jarkman/shonkbot/doc/img/phototranstisor.jpg

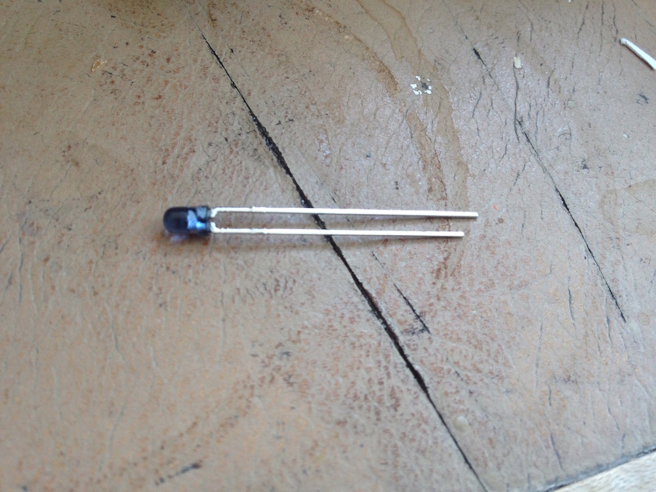
doc/img/phototranstisor.jpg
