jarkman/shonkbot/doc/img/tape1.jpg

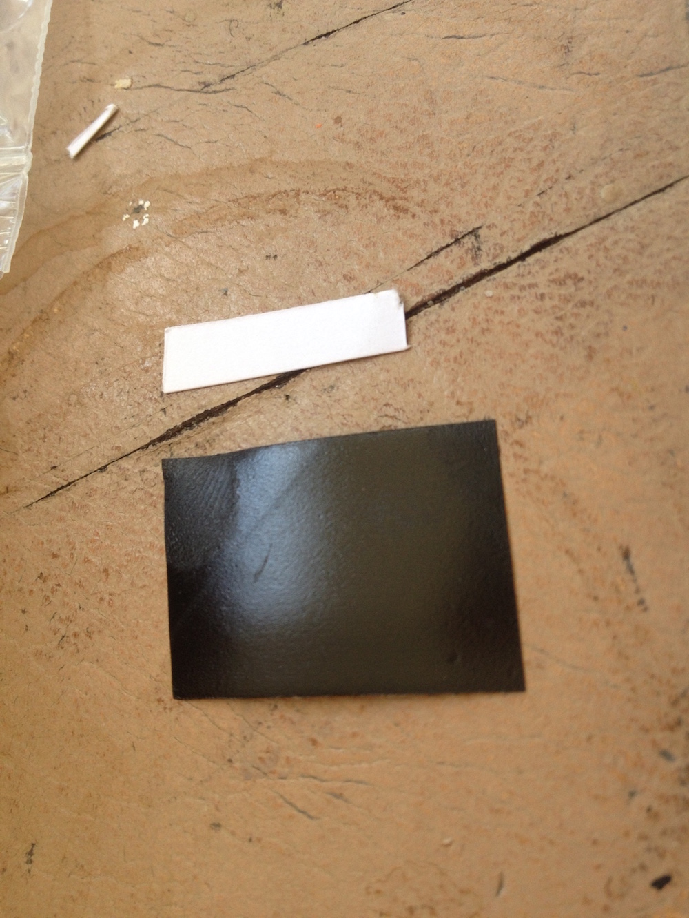
doc/img/tape1.jpg
