jarkman/shonkbot/doc/fritzing/connect_battery.png

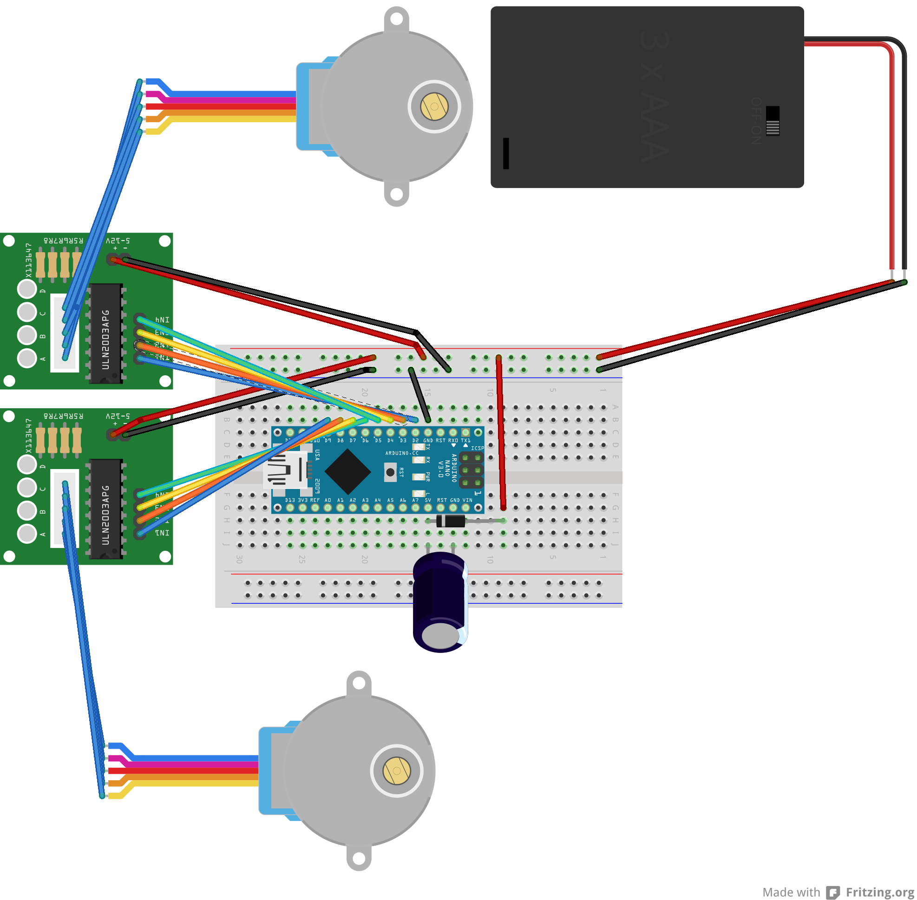
doc/fritzing/connect_battery.png
