jarkman/shonkbot/doc/fritzing/connect_motors2.png

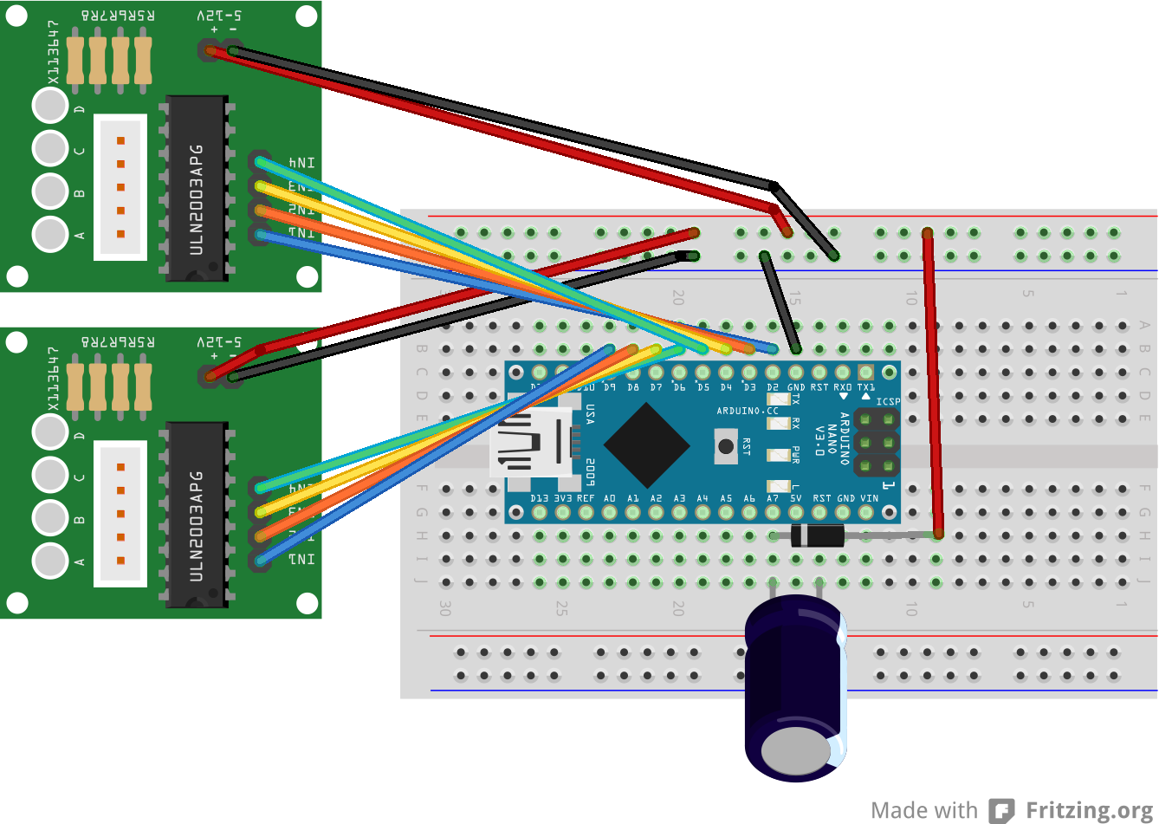
doc/fritzing/connect_motors2.png
