jarkman/shonkbot/doc/fritzing/connect_motors.png

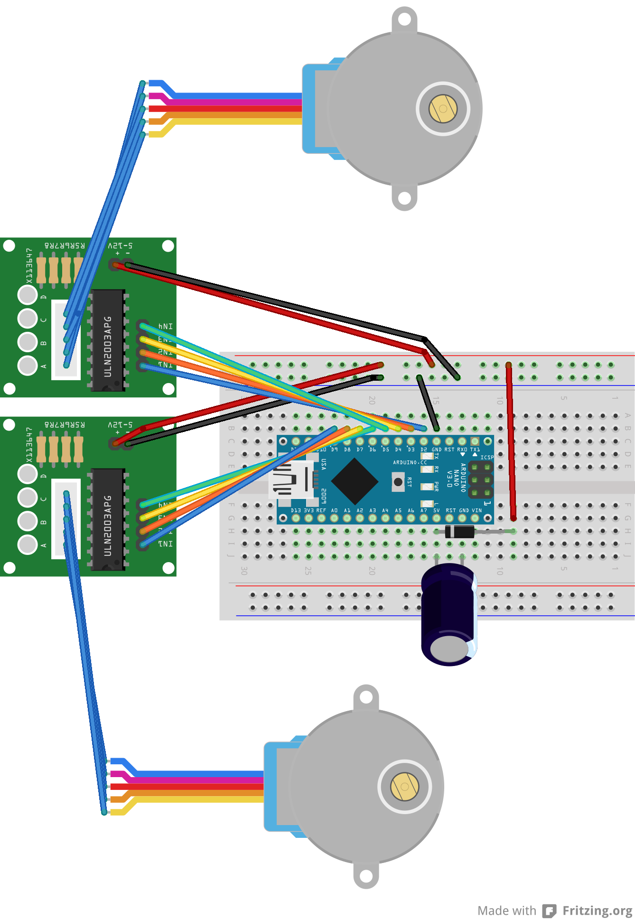
doc/fritzing/connect_motors.png
