jarkman/shonkbot/doc/fritzing/connect_power_supply.png

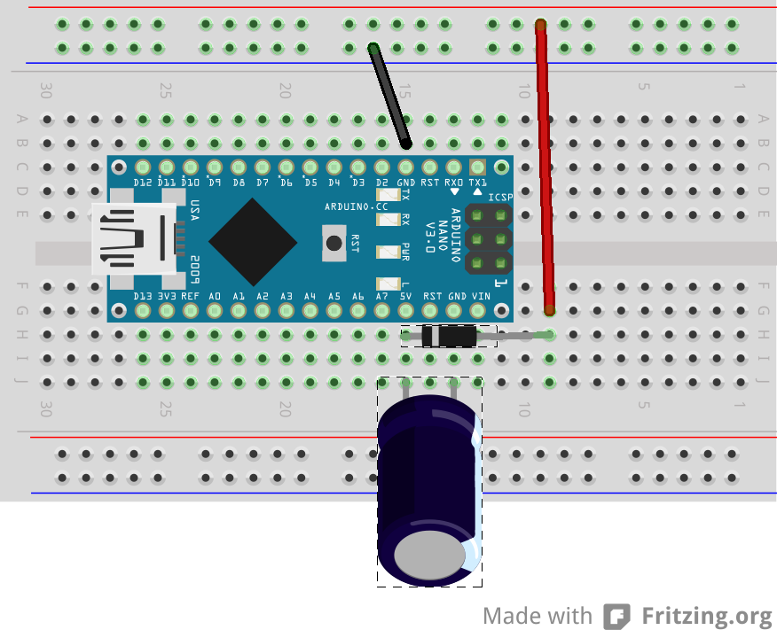
doc/fritzing/connect_power_supply.png
