jarkman/shonkbot/doc/fritzing/ir.png

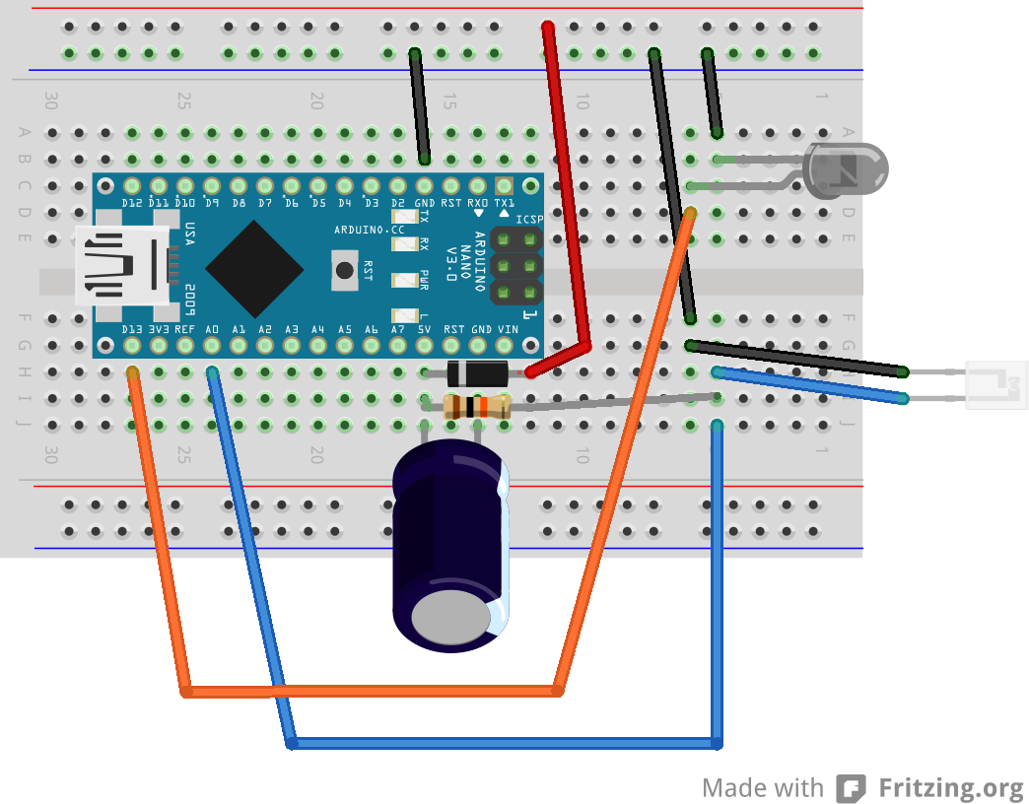
doc/fritzing/ir.png
