jarkman/shonkbot/doc/fritzing/just_led.png

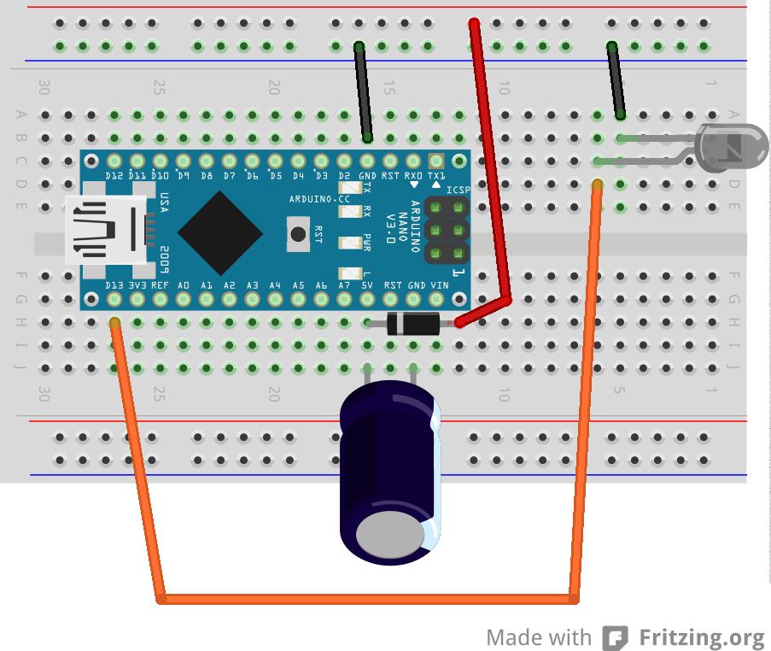
doc/fritzing/just_led.png
