jarkman/shonkbot/doc/fritzing/shonkbot.png

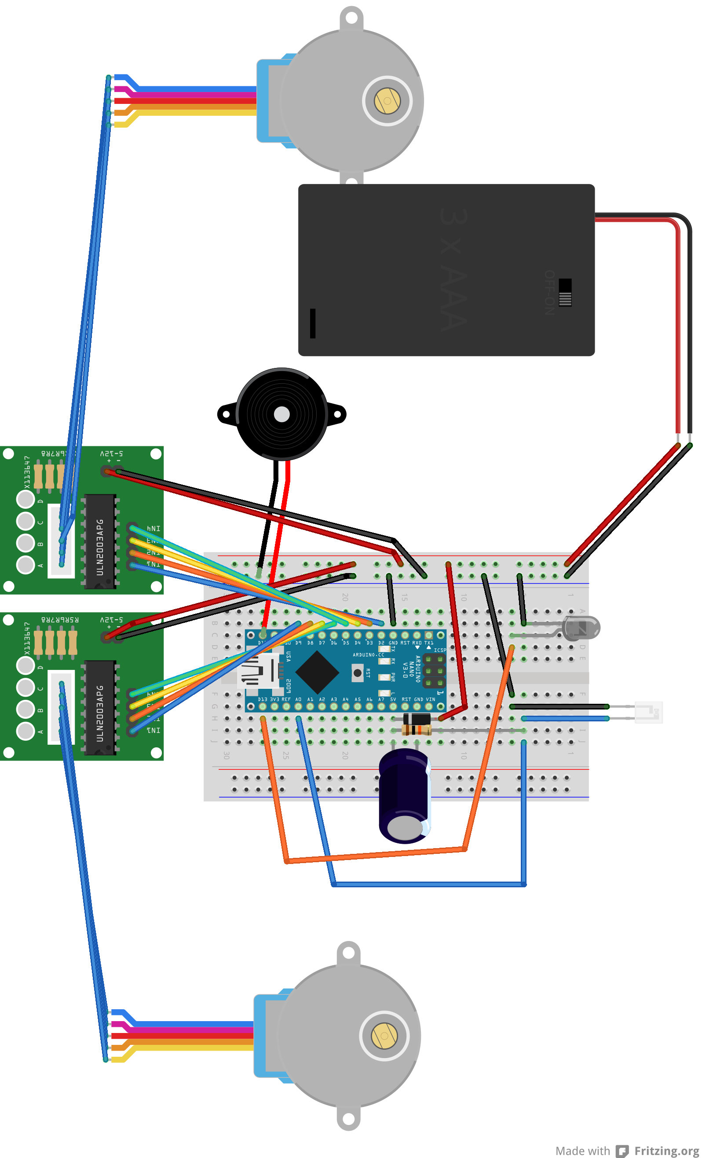
doc/fritzing/shonkbot.png
