jarkman/shonkbot/doc/img/big_led.png

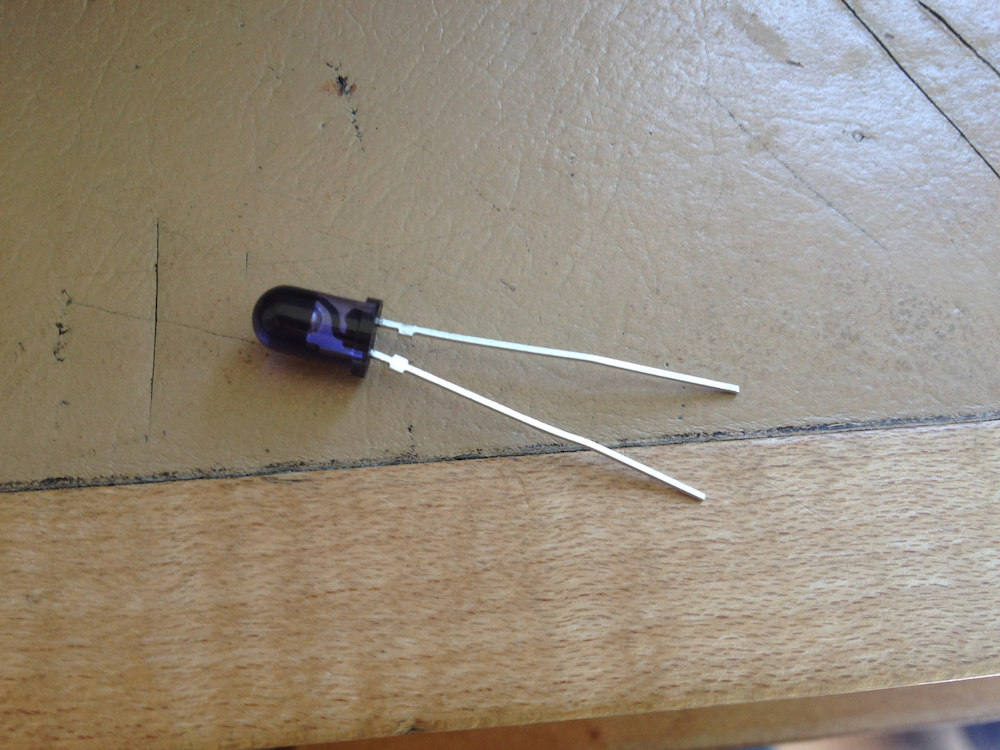
doc/img/big_led.png
