jarkman/shonkbot/doc/img/ir_led.jpg

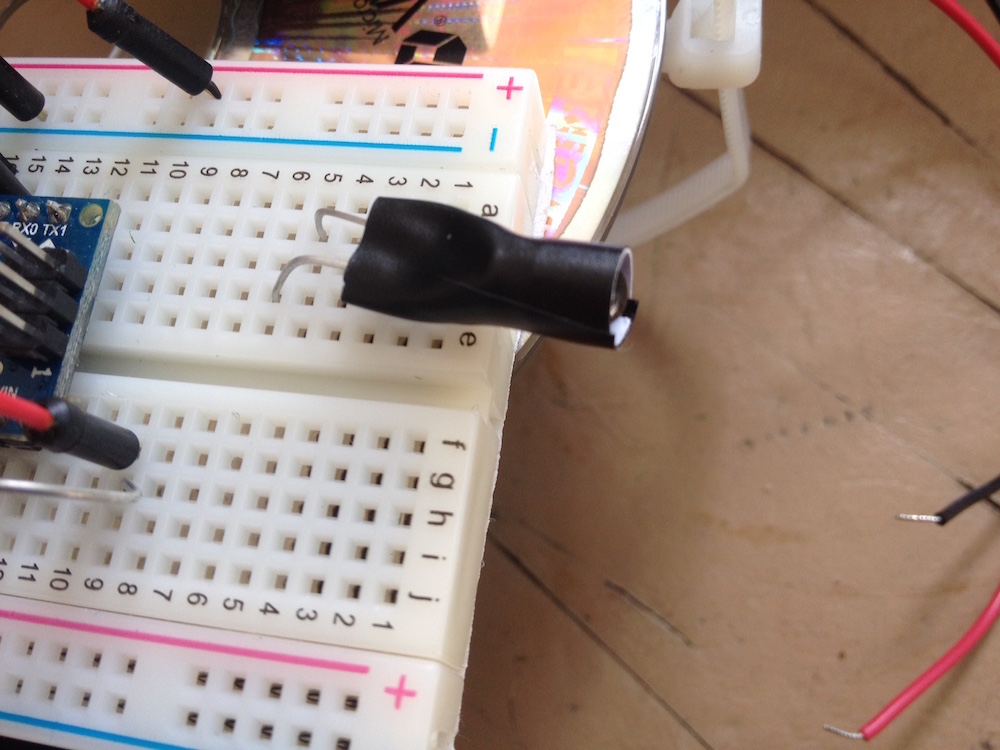
doc/img/ir_led.jpg
