jarkman/shonkbot/doc/img/led_prototransistor.jpg

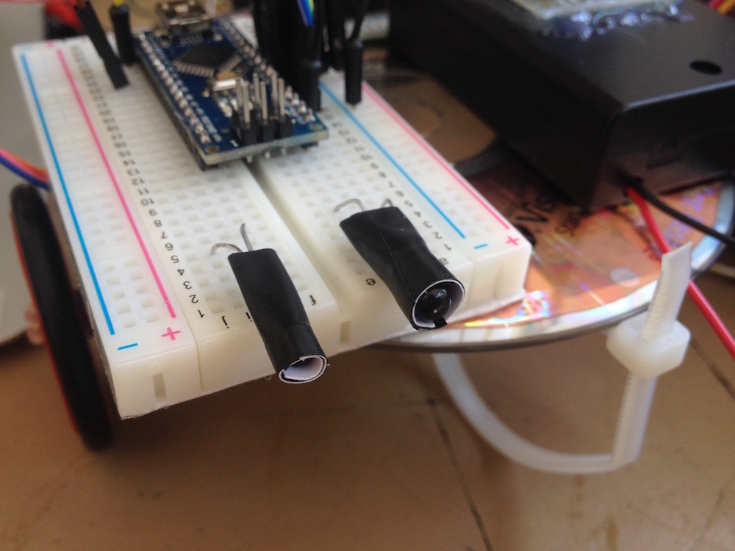
doc/img/led_prototransistor.jpg
