jarkman/shonkbot/doc/img/tape2.jpg

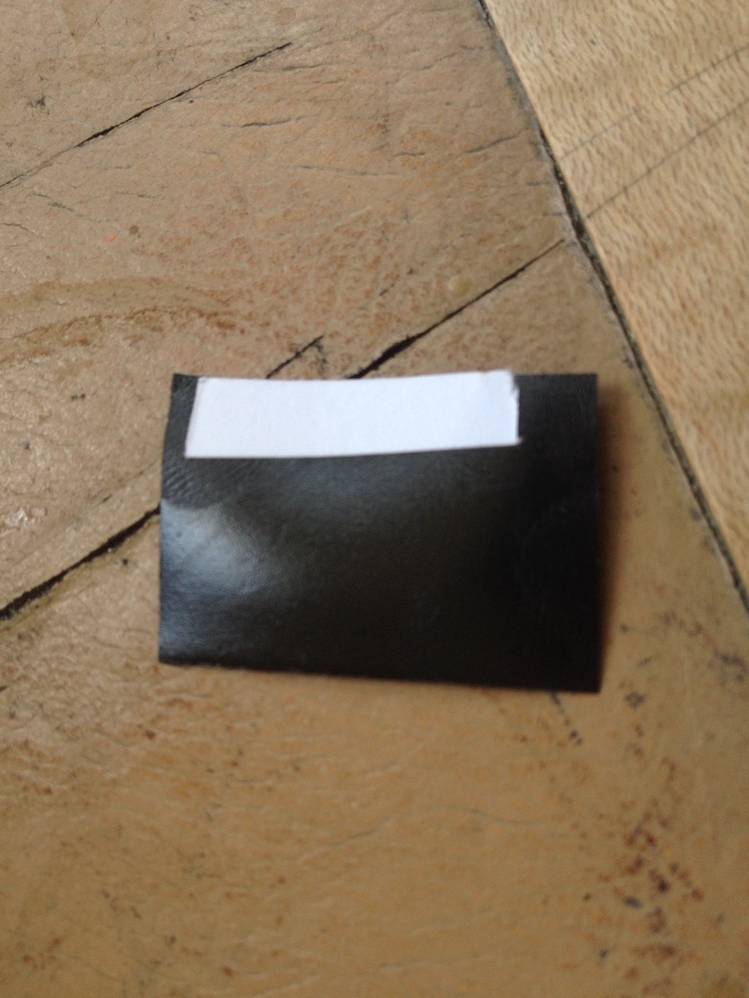
doc/img/tape2.jpg
