jarkman/shonkbot/doc/img/tape3.jpg

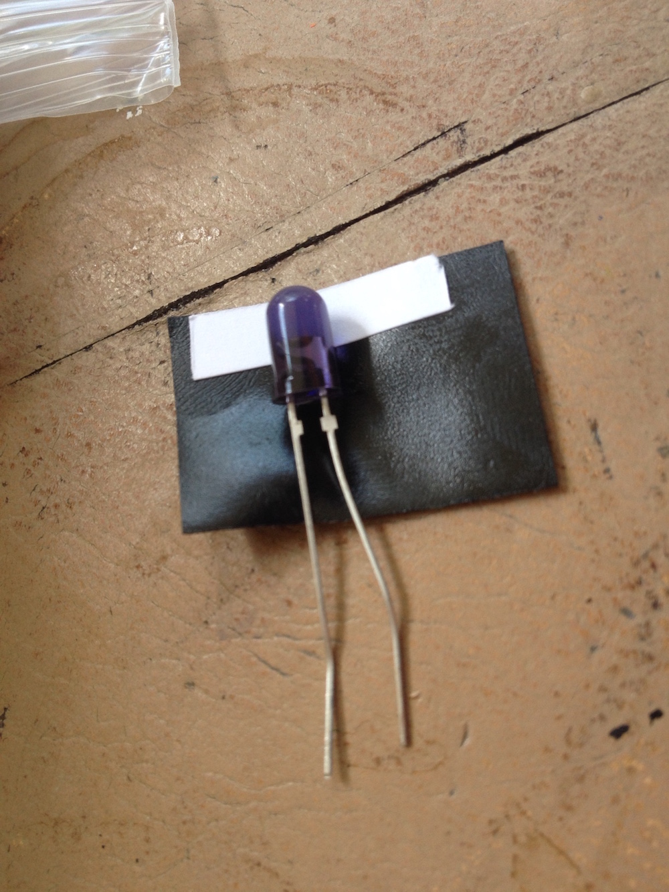
doc/img/tape3.jpg
