jarkman/shonkbot/doc/img/tape4.jpg

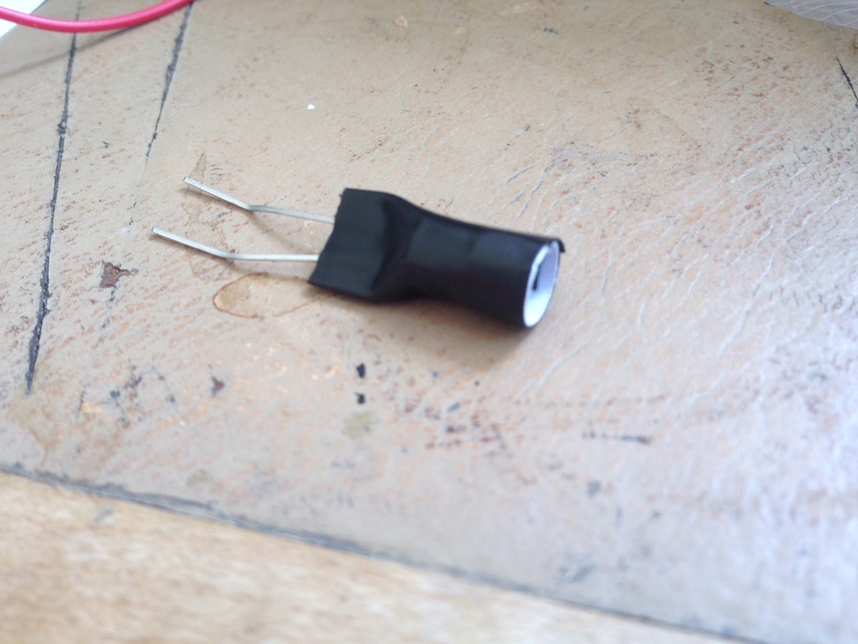
doc/img/tape4.jpg
