jarkman/shonkbot/doc/fritzing/connect_battery.pdf

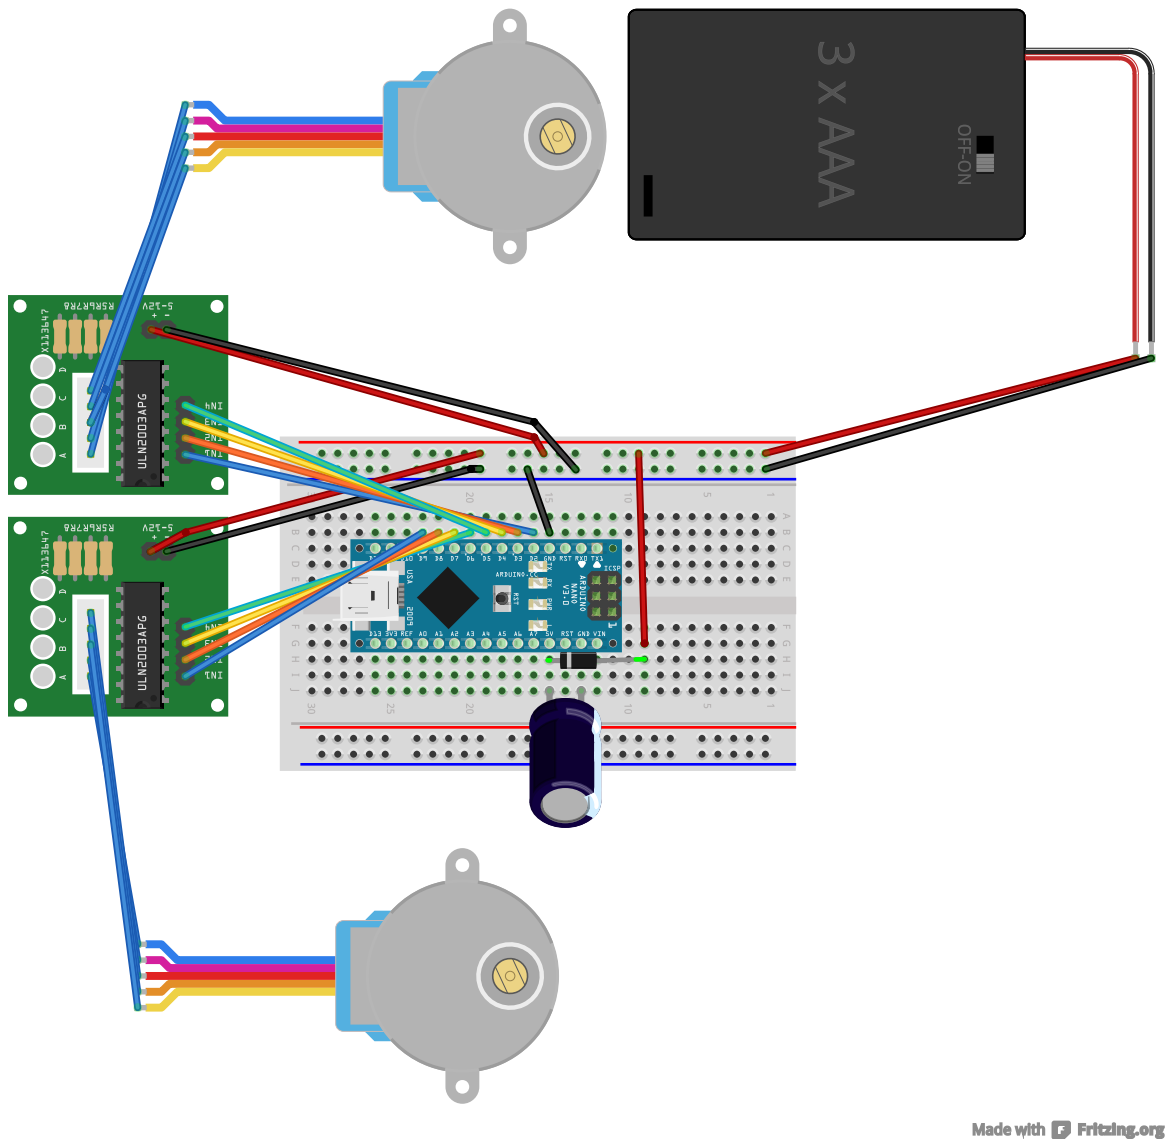
[picture p16: page 1]
