jarkman/shonkbot/doc/fritzing/connect_motors.pdf

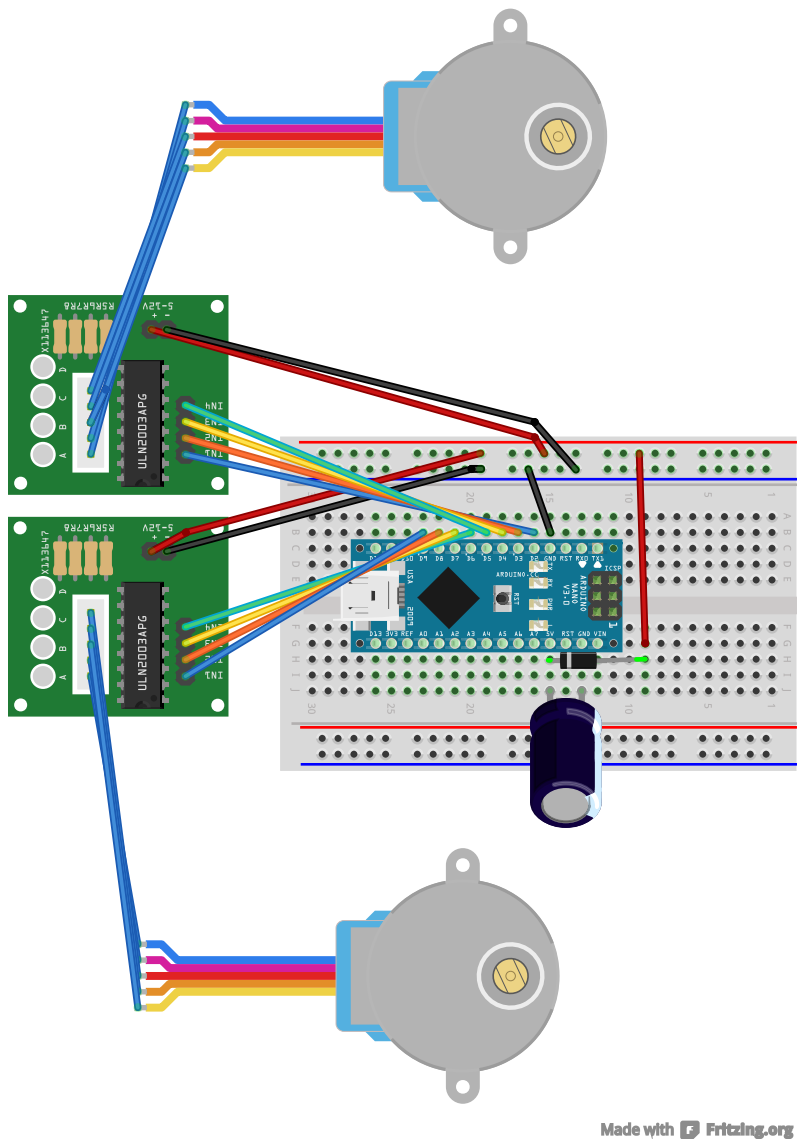
[picture p17: page 1]
