jarkman/shonkbot/doc/fritzing/connect_motors2.pdf

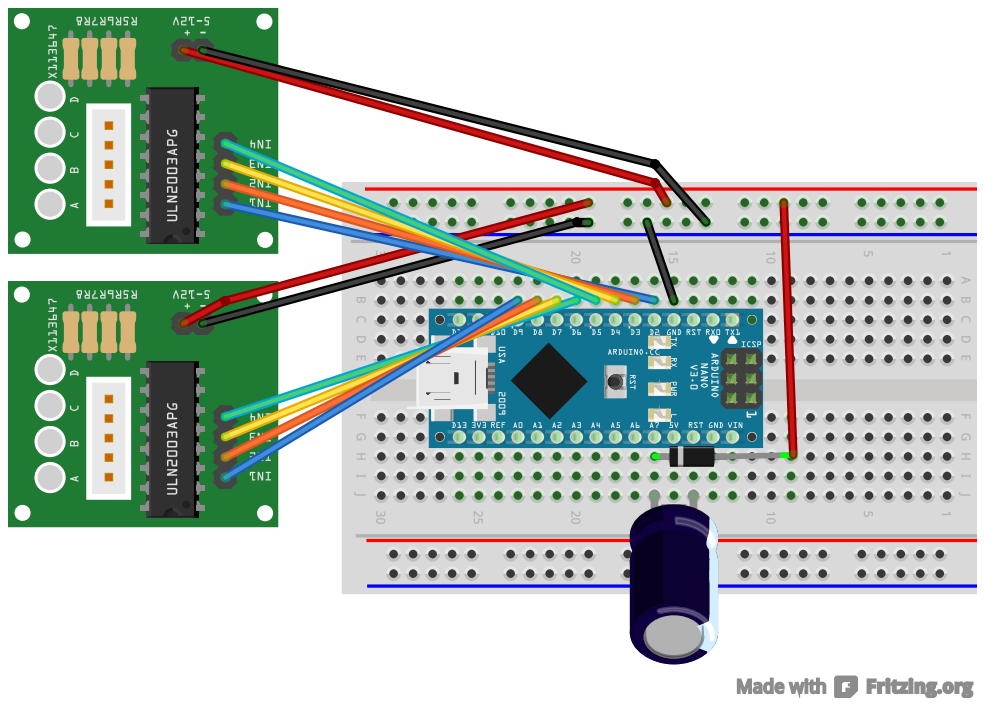
[picture p18: page 1]
