jarkman/shonkbot/doc/fritzing/shonkbot.pdf

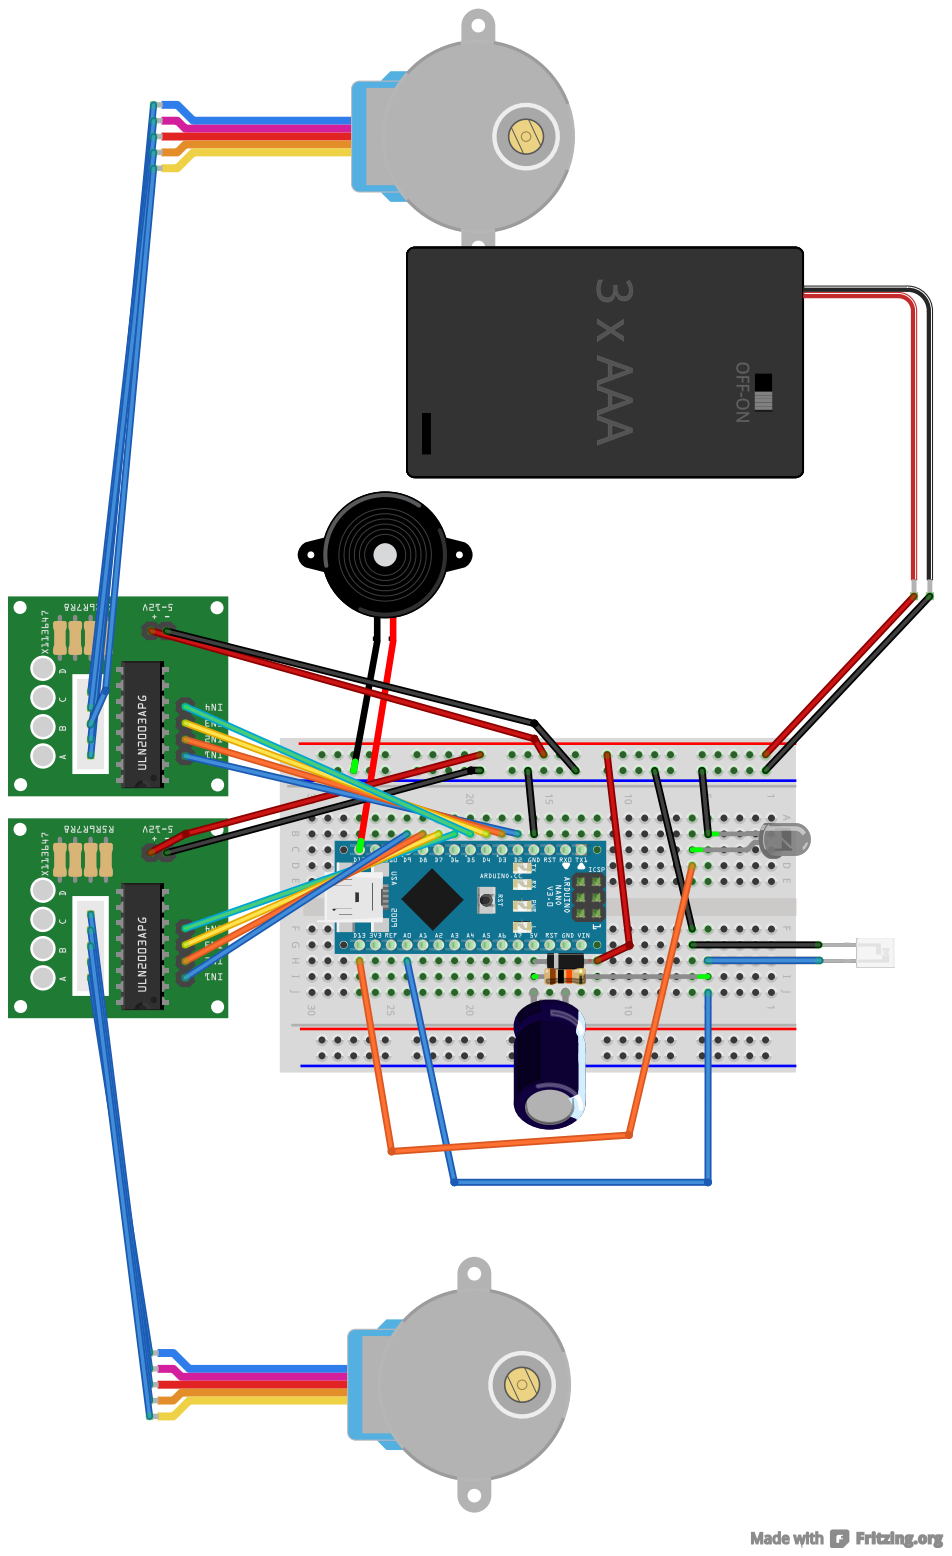
[picture p19: page 1]
