jarkman/shonkbot/doc/fritzing/connect_power_supply.pdf

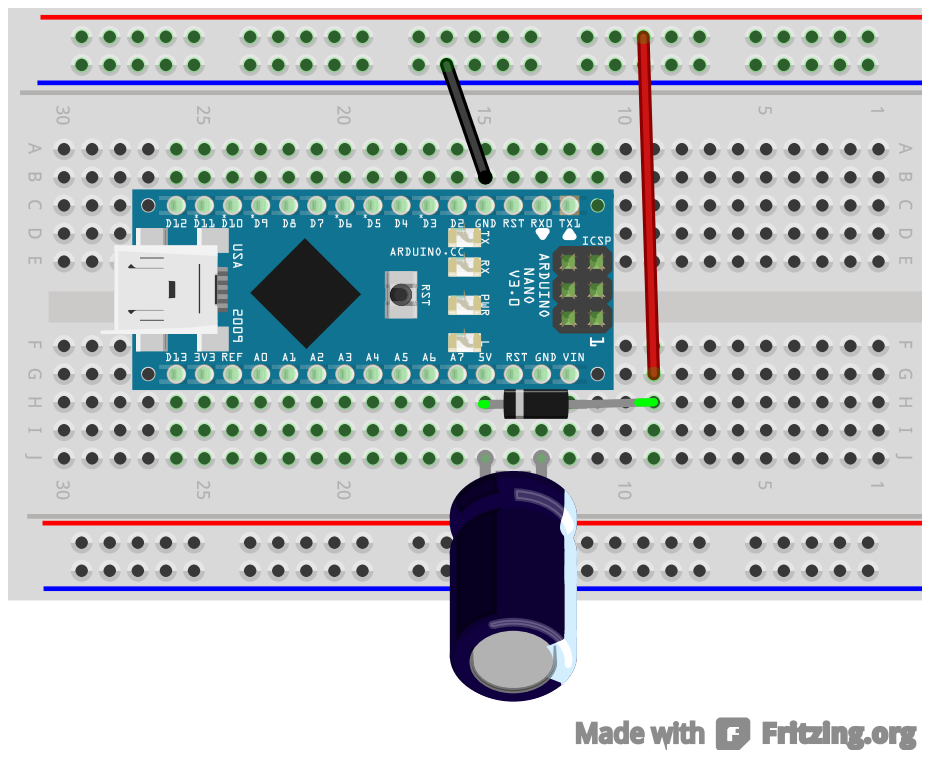
[picture p20: page 1]
