jarkman/shonkbot/doc/fritzing/connect_power_to_motors.pdf

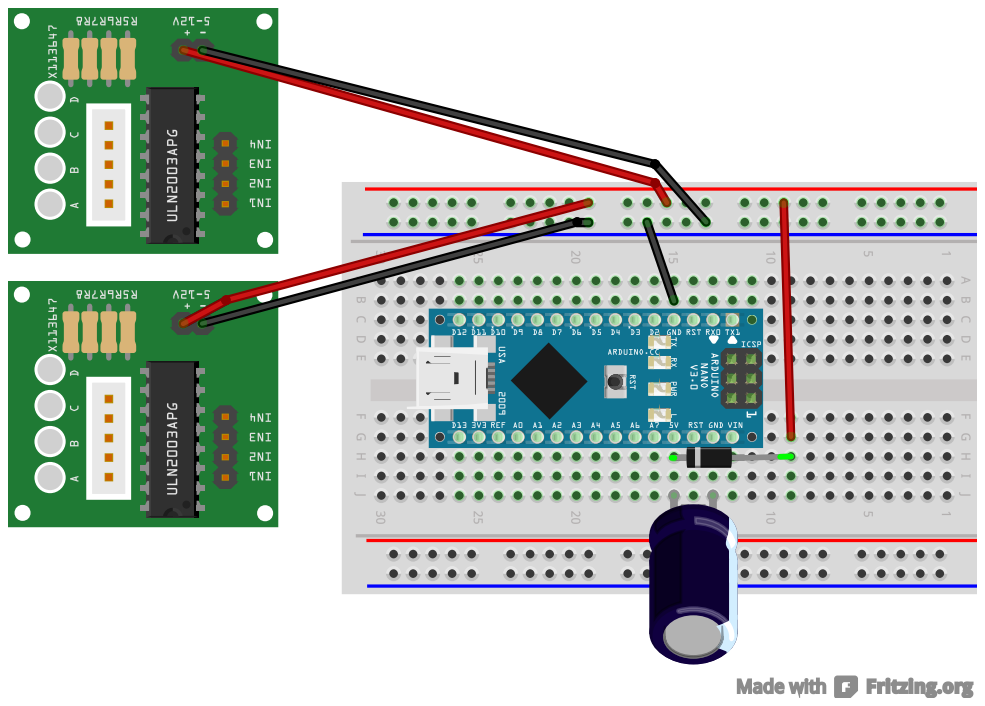
[picture p21: page 1]
