jarkman/shonkbot/doc/fritzing/ir.pdf

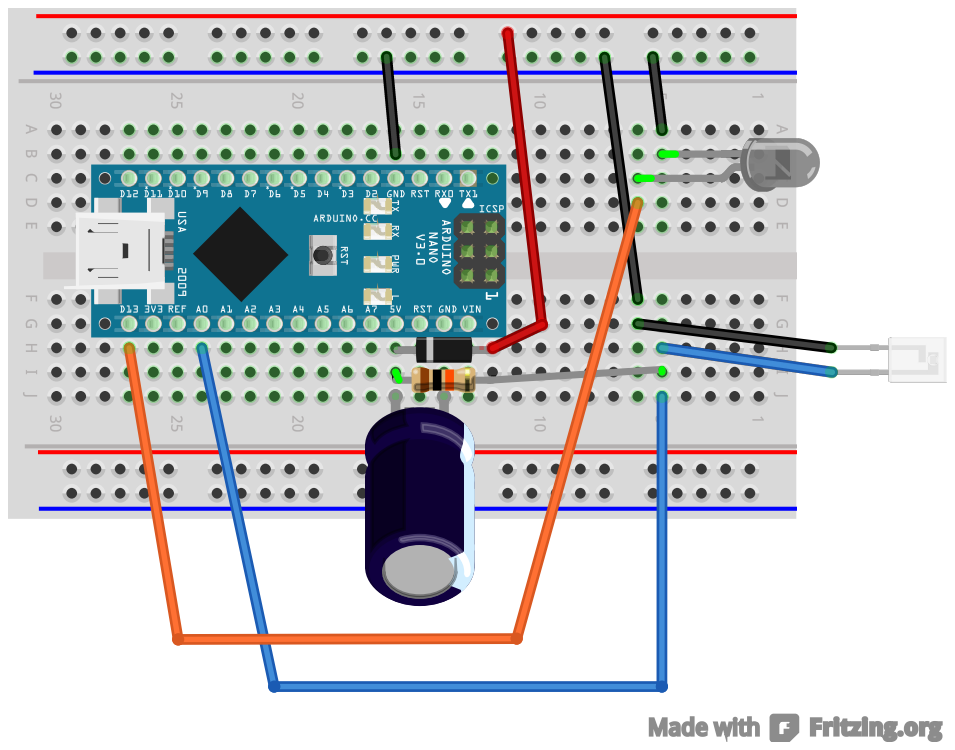
[picture p22: page 1]
