jarkman/shonkbot/doc/fritzing/just_led.pdf

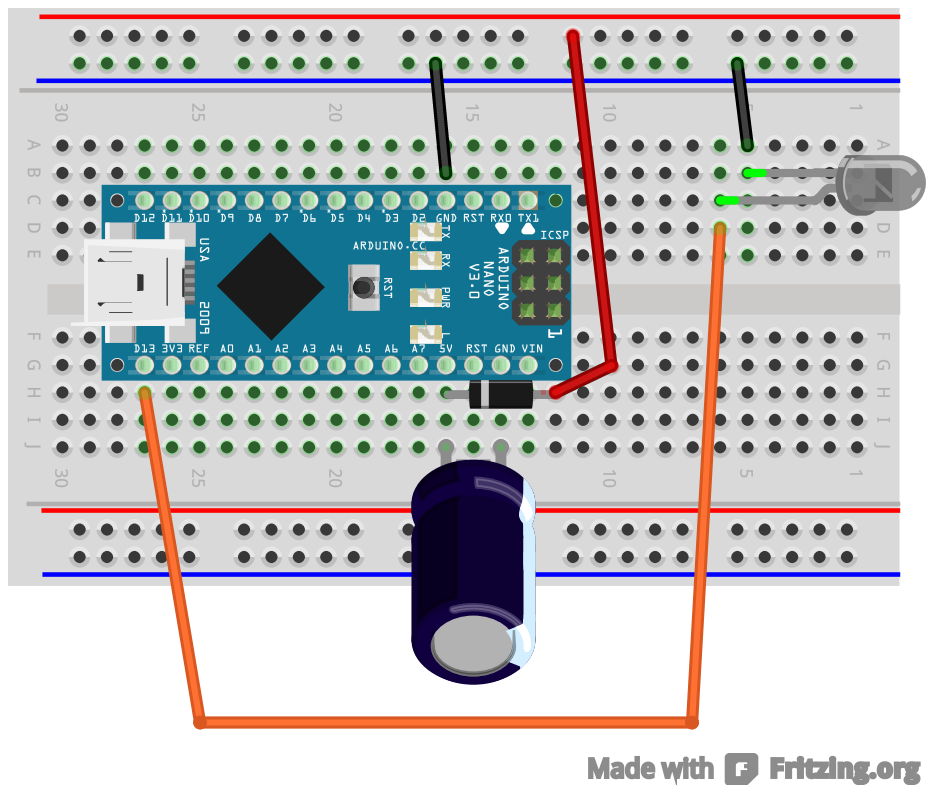
[picture p23: page 1]
