jarkman/shonkbot/doc/fritzing/shonkbot_drawing.pdf

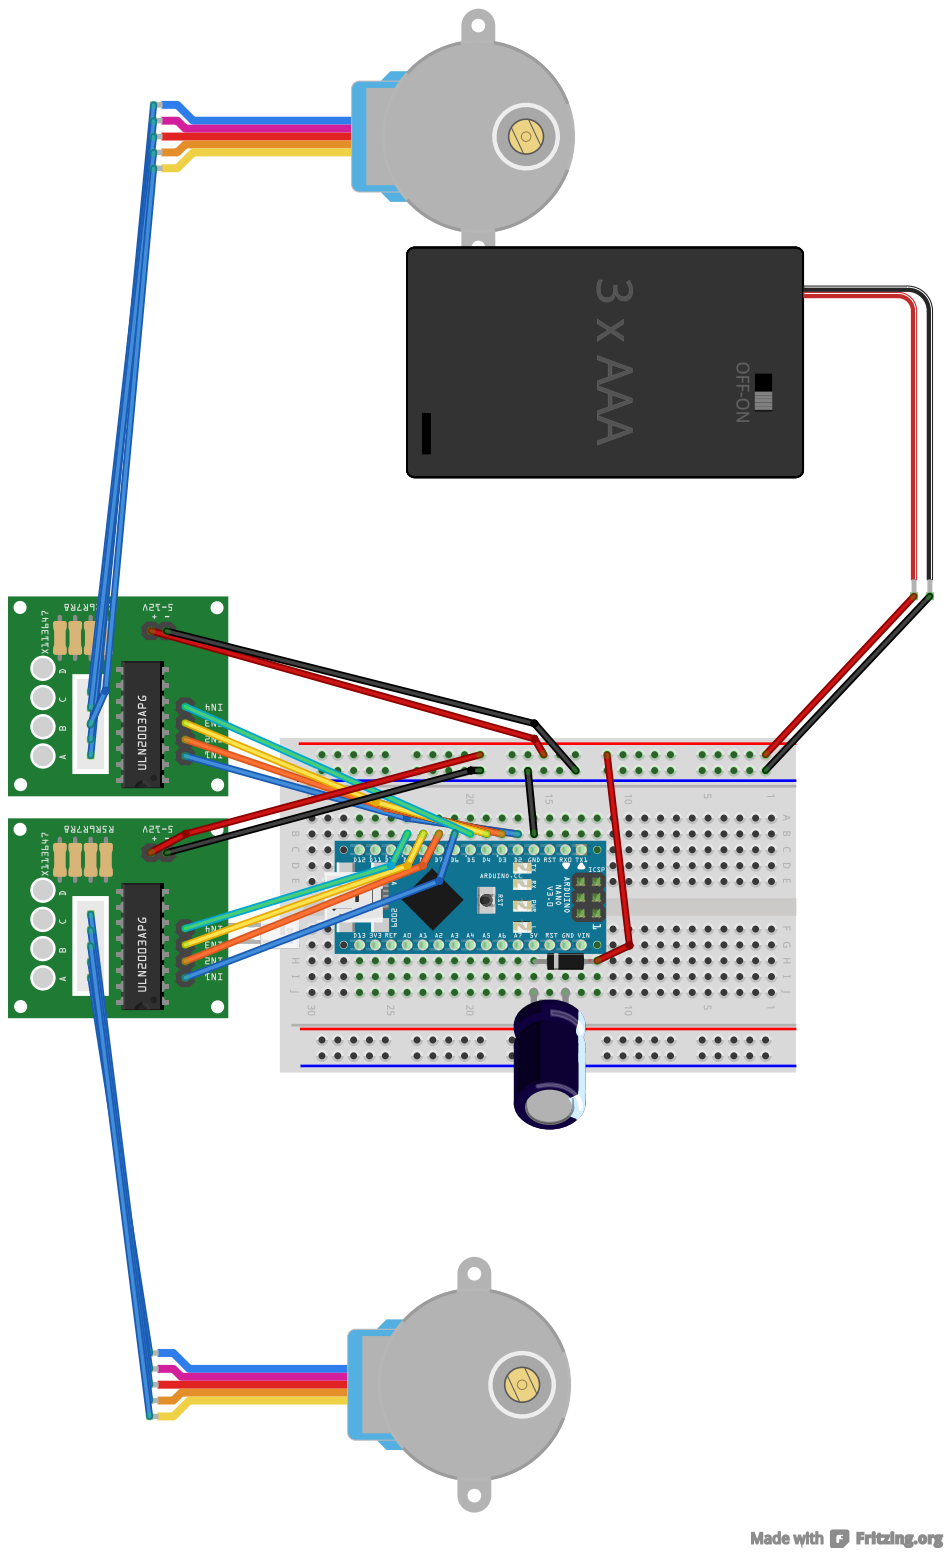
[picture p24: page 1]
