jarkman/shonkbot/doc/fritzing/shonkbot_no_motors.pdf

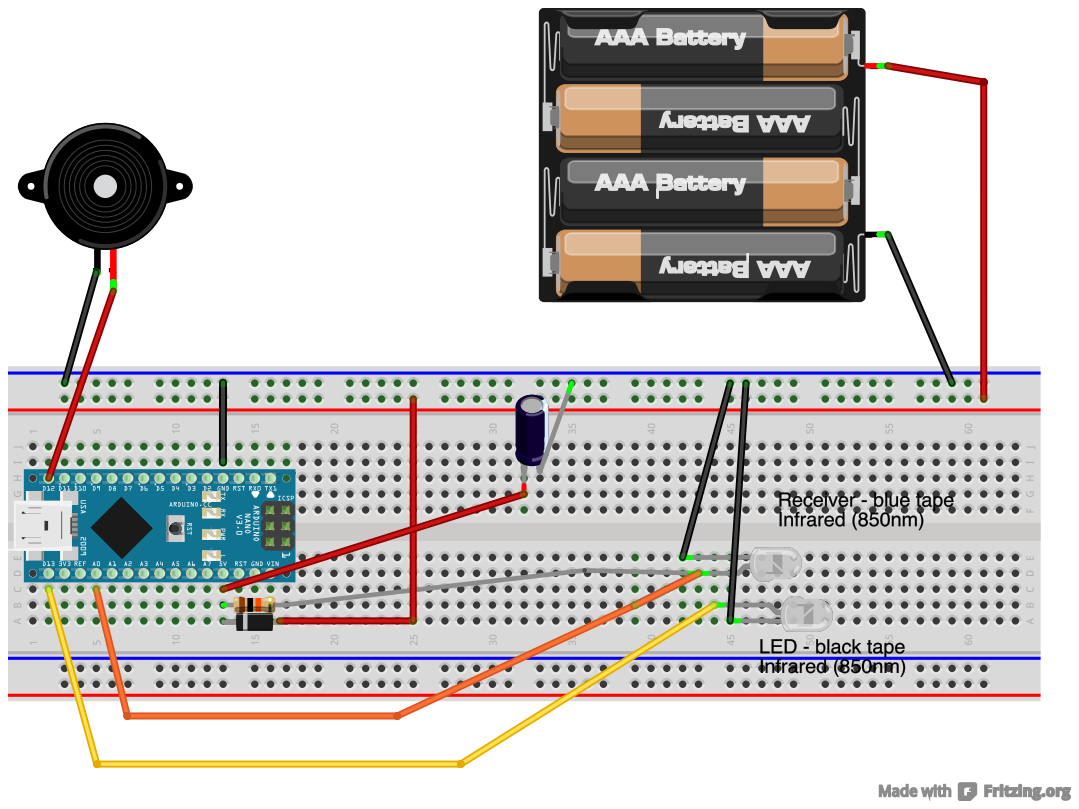
[picture p25: page 1]
