jarkman/shonkbot/doc/fritzing/shonkbot_swarm.pdf

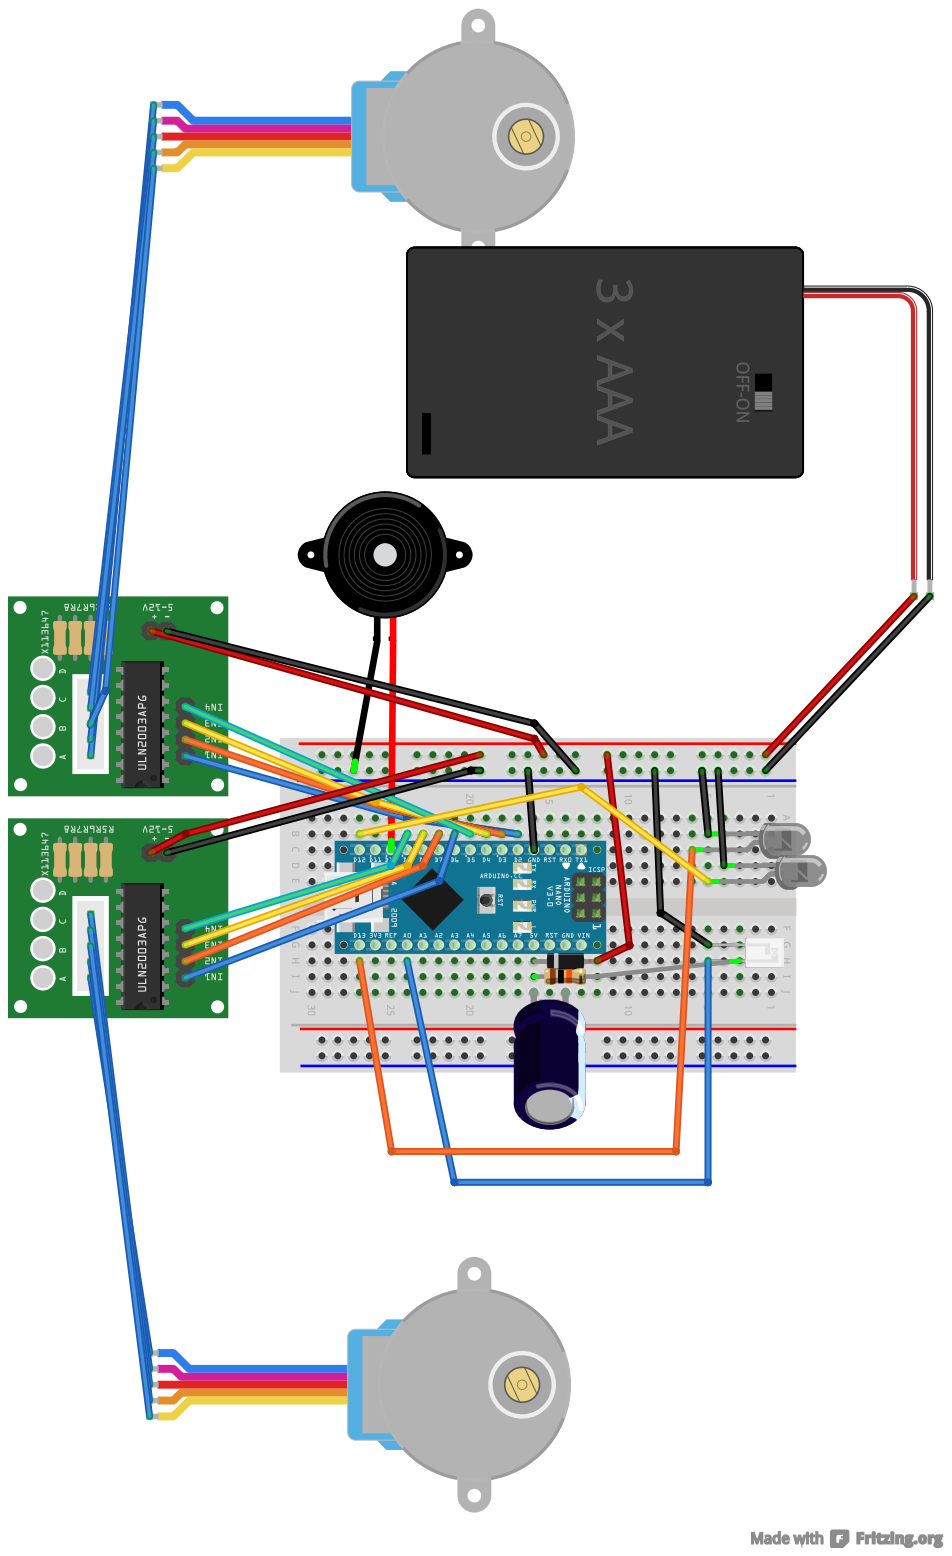
[picture p26: page 1]
