jarkman/shonkbot/(list of files, drawings)

Other design files:
doc/fritzing/connect_battery.fzz
doc/fritzing/connect_motors2.fzz
doc/fritzing/connect_motors.fzz
doc/fritzing/connect_power_supply.fzz
doc/fritzing/connect_power_to_motors.fzz
doc/fritzing/foo.fzz
doc/fritzing/ir.fzz
doc/fritzing/just_led.fzz
doc/fritzing/shonkbot.fzz
doc/fritzing/shonkbot_drawing.fzz
doc/fritzing/shonkbot_no_motors.fzz
doc/fritzing/shonkbot_swarm.fzz
