jarkman/shonkbot/(commit log)

2015-06-05 Unchecked Fritzing docs
    [shonkbot.fzz]
2015-06-06 Forgot to add power to the driver boards
    [shonkbot.fzz]
2015-06-06 Fix inadvertently moved breadboard
    [shonkbot.fzz]
2015-06-06 Improve layout slightly
    [shonkbot.fzz]
2015-06-06 Libby confused by fritzing
    [shonkbot.fzz]
2015-06-06 Connect up the piezo properly
    [shonkbot.fzz]
2015-06-06 Swarm version
    [shonkbot_swarm.fzz]
2015-06-06 Simplest drawing robot
    [shonkbot_drawing.fzz]
2015-06-06 Fix export problem
    [shonkbot_drawing.fzz]
2015-06-06 fixed wheel diameter
2015-06-06 fixed script to use twoWheel
    [TwoWheel.cpp, TwoWheel.h]
2015-06-07 fixed reversing beeps, tweaked speed
    [shonkbot_detector.ino, wander.ino]
2015-06-07 Various Fritzing diagrams for the istructions
    [Untitled.fzz, connect_battery.fzz, connect_motors.fzz, connect_motors2.fzz, connect_power_supply.fzz, connect_power_to_motors.fzz, foo.fzz, ir.fzz]
2015-06-07 Fixed buglet in the docs
    [connect_battery.fzz, connect_motors.fzz, connect_motors2.fzz, connect_power_supply.fzz, connect_power_to_motors.fzz, ir.fzz, just_led.fzz, shonkbot.fzz]
2015-06-13 Fixed fritzing diagrams plus images from the doc
    [Untitled.fzz, connect_battery.fzz, connect_motors.fzz, connect_motors2.fzz, connect_power_supply.fzz, connect_power_to_motors.fzz, foo.fzz, ir.fzz]
2015-06-14 Updated with advice 'if you got the arduino from us'
2015-07-02 Fix error in motor connections
    [connect_battery.fzz, connect_motors.fzz, connect_motors2.fzz, shonkbot.fzz, shonkbot_no_motors.fzz]
2015-08-24 Update README.md
    couple of little clarifications
2016-10-22 Added BOM
2019-07-27 Changed a couple of links to new copies
    ..because of some access permissions problems
